bassistTech/PgUpDnPedal--Esp32--Deprecated/img/copy.png

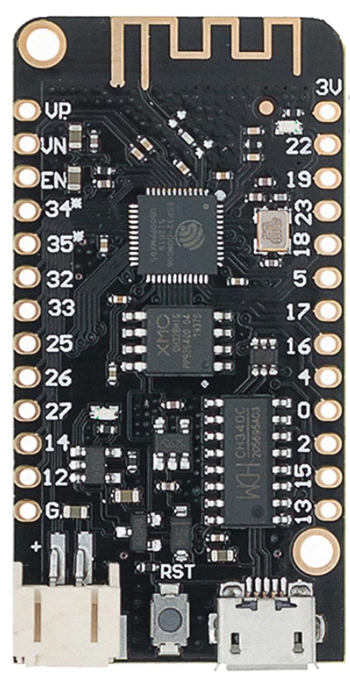
img/copy.png
