bassistTech/PgUpDnPedal--Esp32--Deprecated/img/picture.png

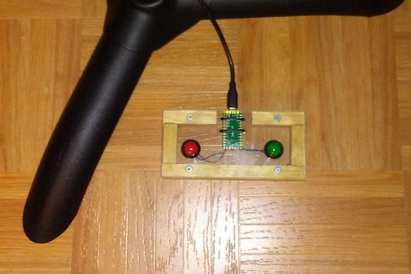
img/picture.png
