bassistTech/PgUpDnPedal--Esp32--Deprecated/img/schem.png

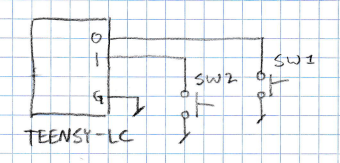
img/schem.png
