bassistTech/PgUpDnPedal--Esp32--Deprecated/img/spfun.png

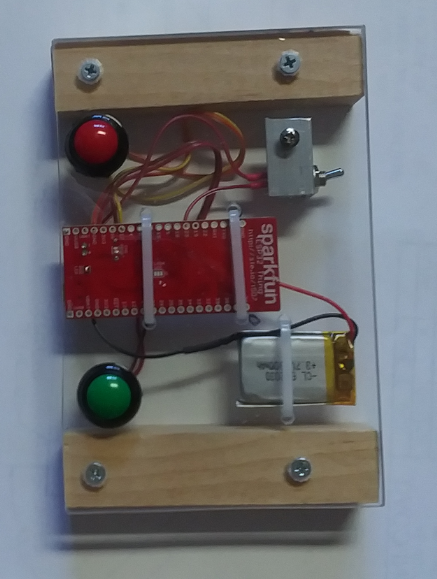
img/spfun.png
