bassistTech/PgUpDnPedal--Esp32--Deprecated/(commit log)

2020-12-08 added Arduino code
2021-12-20 added pics for both ESP32 versions
2021-12-24 moved stuff about WEMOS board to bottom section
2022-04-24 added beginnings of 3rd button
2023-01-09 added charging feature
